VanGame666/Thermal_imager/Picture/正面.png

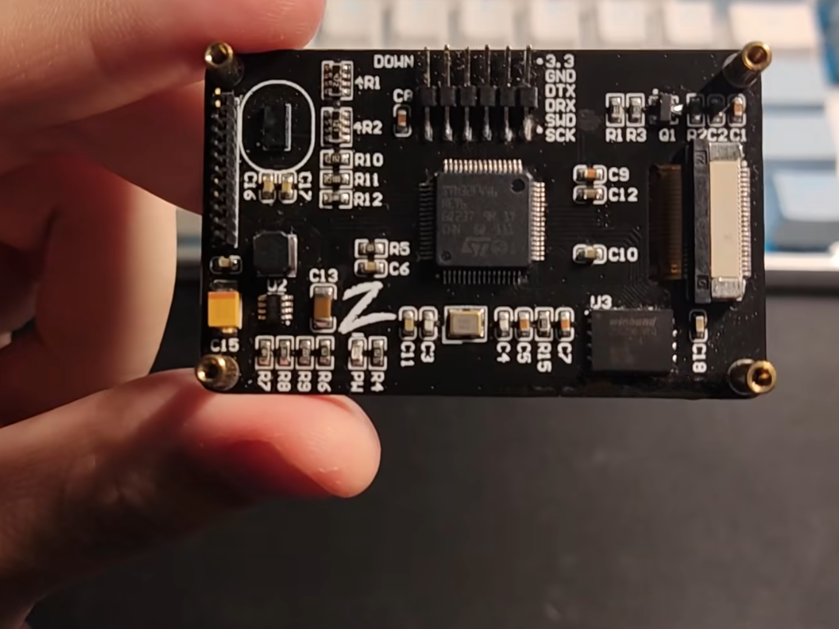
Picture/正面.png
