VanGame666/Thermal_imager/Picture/效果2.png

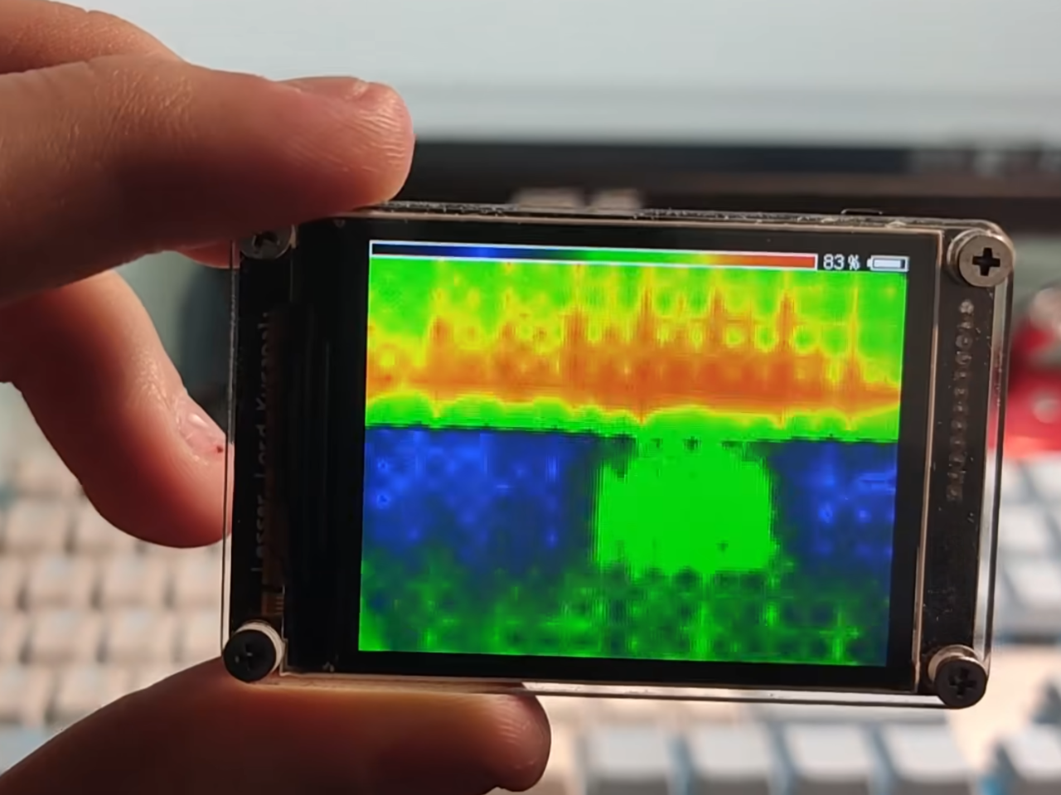
Picture/效果2.png
