VanGame666/Thermal_imager/Picture/Thermal_imager_Pcb(Down).png

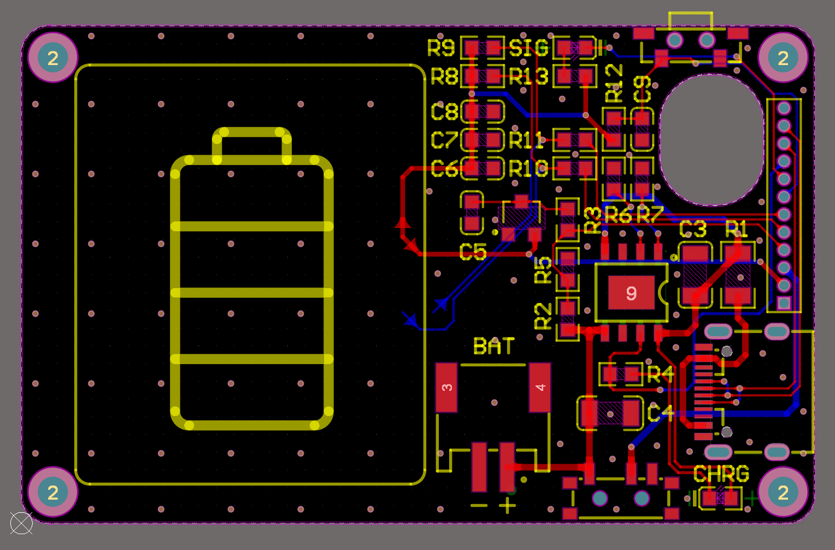
Picture/Thermal_imager_Pcb(Down).png
