VanGame666/Thermal_imager/Picture/Thermal_imager_Pcb(Up).png

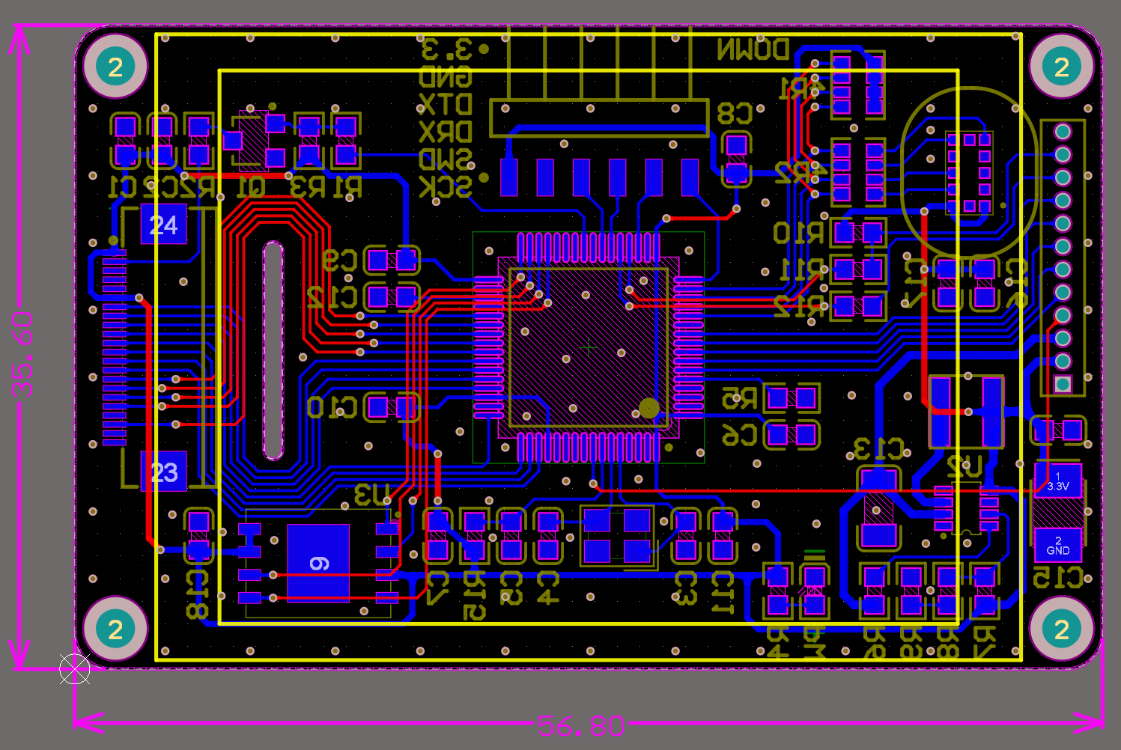
Picture/Thermal_imager_Pcb(Up).png
