VanGame666/Thermal_imager/Picture/Thermal_imager_Sch(Down).png

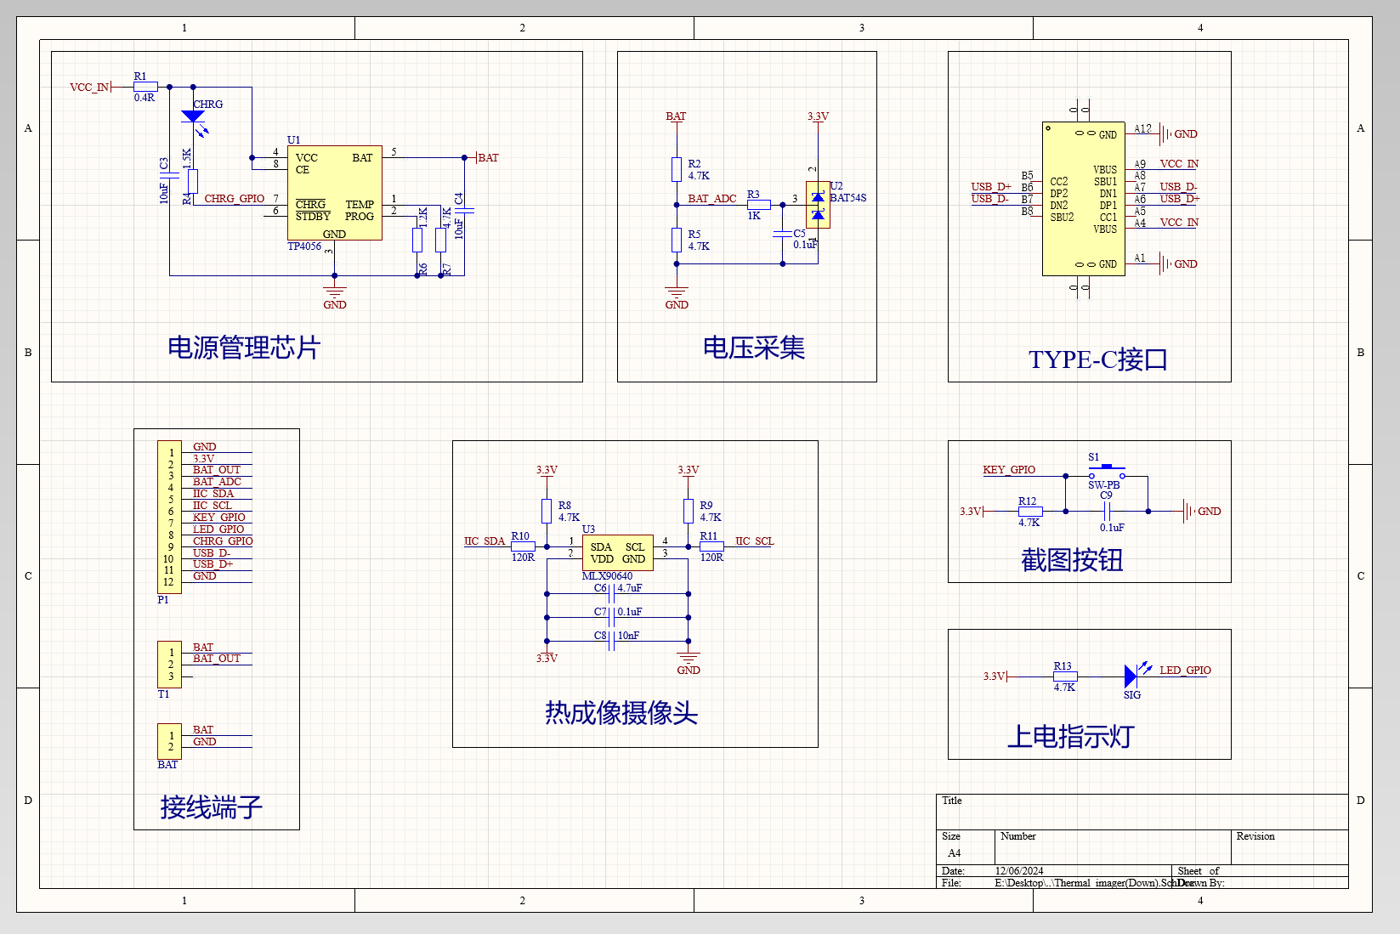
Picture/Thermal_imager_Sch(Down).png
