VanGame666/Thermal_imager/Picture/Thermal_imager_Sch(Up).png

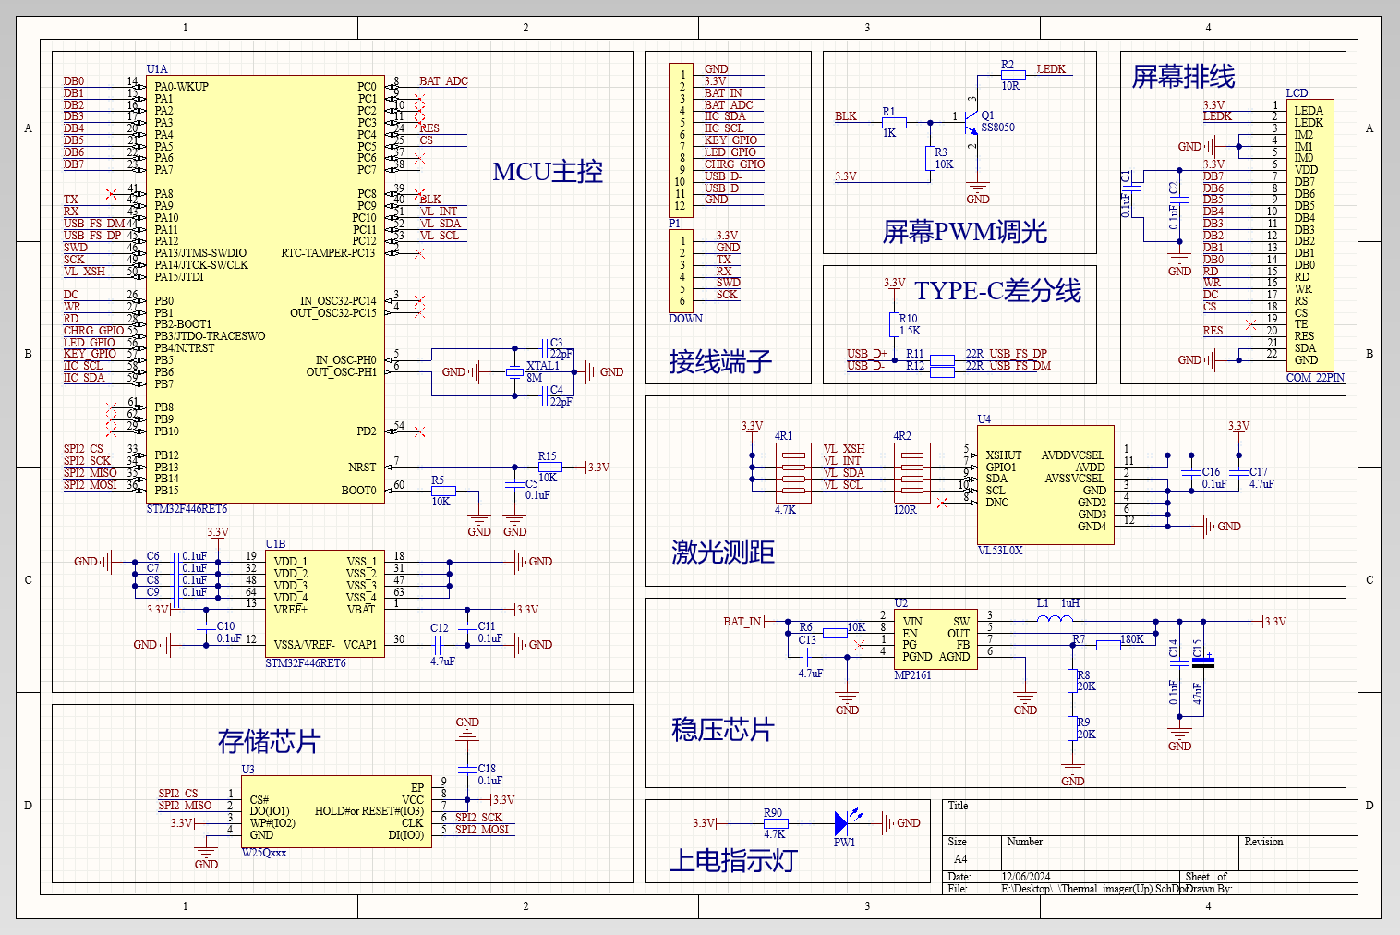
Picture/Thermal_imager_Sch(Up).png
