VanGame666/Thermal_imager/Picture/反面.png

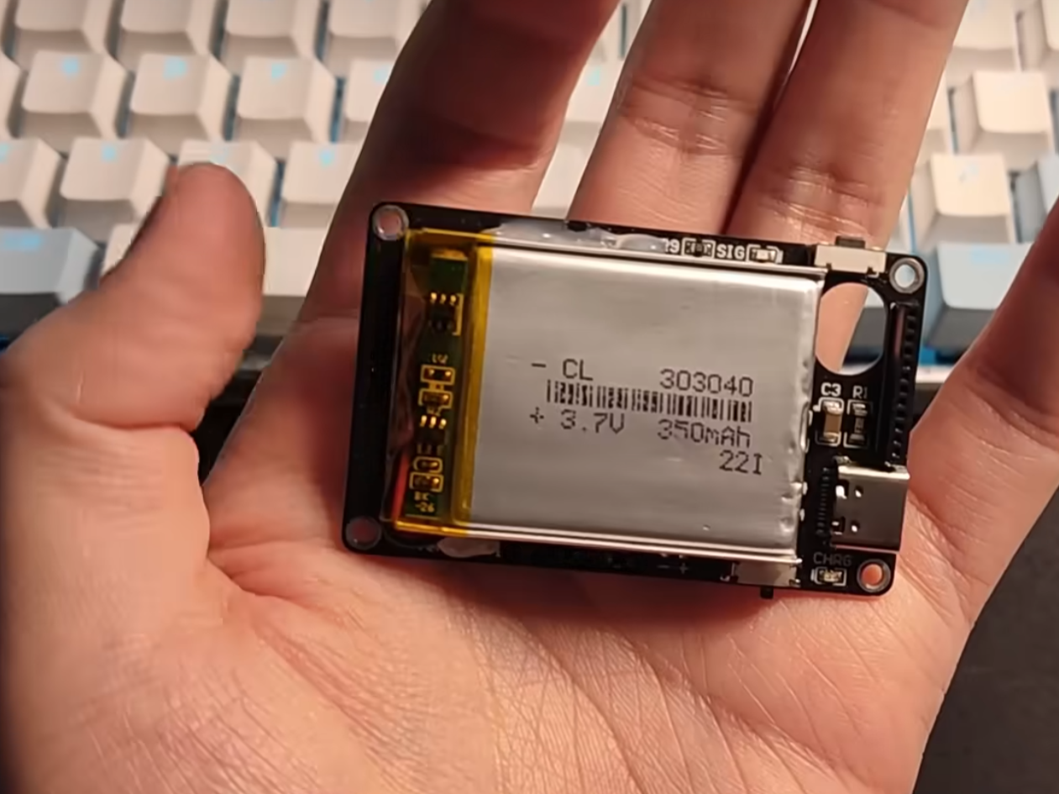
Picture/反面.png
