VanGame666/Thermal_imager/Picture/屏幕.png

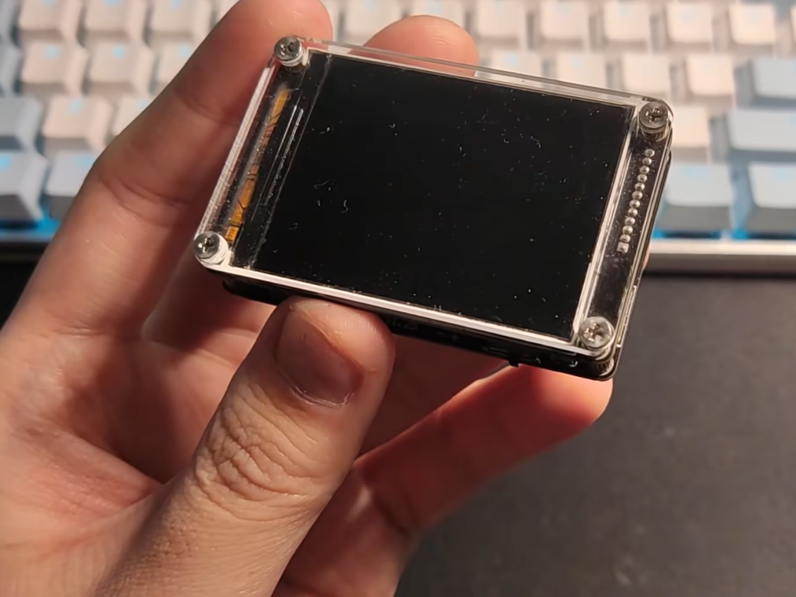
Picture/屏幕.png
