VanGame666/Thermal_imager/Picture/效果1.png

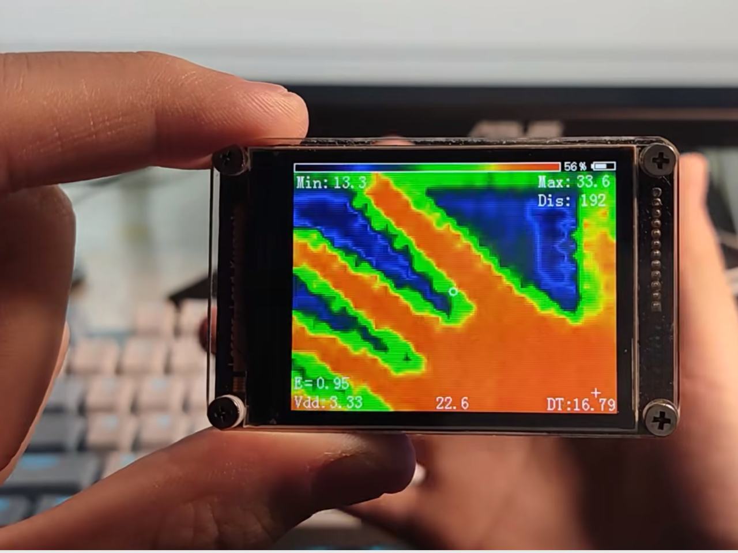
Picture/效果1.png
