VanGame666/Thermal_imager/(list of files, drawings)

Other design files:
Hardware/Thermal_imager(Down)/Thermal_imager(Down).PcbDoc
Hardware/Thermal_imager(Down)/Thermal_imager(Down).PrjPcb
Hardware/Thermal_imager(Down)/Thermal_imager(Down).SchDoc
Hardware/Thermal_imager(Up)/Thermal_imager(Up).PcbDoc
Hardware/Thermal_imager(Up)/Thermal_imager(Up).PrjPcb
Hardware/Thermal_imager(Up)/Thermal_imager(Up).SchDoc
