VanGame666/Thermal_imager/Software/Core/Src/main.c

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
/* Includes ------------------------------------------------------------------*/
#include "main.h"
#include "adc.h"
#include "dma.h"
#include "fatfs.h"
#include "i2c.h"
#include "spi.h"
#include "tim.h"
#include "usart.h"
#include "usb_device.h"
#include "gpio.h"

/* USER CODE BEGIN Includes */

#include <stdio.h>
#include <Processing_library.h>

#include "lcd.h"
#include "lcd_init.h"
#include "w25qxx.h"
#include "vl53l0x.h"
#include "mlx90640.h"
#include "bmp.h"
#include "usbd_core.h"
#include "pic.h"

/* USER CODE END Includes */


/* USER CODE BEGIN PV */

FATFS fs;													/* FatFs文件系统对象 */
FIL file;													/* 文件对象 */
FRESULT f_res;                    /* 文件操作结果 */
UINT fnum;            					  /* 文件成功读写数量 */
BYTE ReadBuffer[1024]={0};        /* 读缓冲区 */
BYTE WriteBuffer[]= "MY shi zhen shuai a\n\r";/* 写缓冲区*/  
BYTE fatfs_work[1024];

/* USER CODE END PV */

void SystemClock_Config(void);
/* USER CODE BEGIN 0 */

uint8_t key_down_sign = 0;		//按键按下标志位

DEVIE_STATE devie_state;

/* USER CODE END 0 */

/**
  * @brief  The application entry point.
  * @retval int
  */
int main(void)
{
  /* MCU Configuration--------------------------------------------------------*/

  /* Reset of all peripherals, Initializes the Flash interface and the Systick. */
  HAL_Init();

  /* Configure the system clock */
  SystemClock_Config();

  /* Initialize all configured peripherals */
  MX_GPIO_Init();
  MX_DMA_Init();
  MX_ADC1_Init();
  MX_I2C1_Init();
  MX_SPI2_Init();
  MX_TIM3_Init();
  MX_USART1_UART_Init();
//  MX_FATFS_Init();
//  MX_USB_DEVICE_Init();
  MX_TIM5_Init();
  MX_TIM6_Init();
  MX_TIM7_Init();
  /* USER CODE BEGIN 2 */

	//LCD
	TIM3 -> CCR4 = 0;
	HAL_TIM_PWM_Start(&htim3,TIM_CHANNEL_4);
	LCD_Init();
	LCD_Fill(0,0,LCD_W,LCD_H,BLACK);
	TIM3 -> CCR4 = LCD_START_LIGHT;

	//W25Qxx
	W25QXX_Init();
	while(W25QXX_ReadID()!=W25Q256)
	{
			printf("w25qxx error\r\n");
			HAL_Delay(1000);
	}
	//MX_USB_DEVICE_Init();
	MX_FATFS_Init();

	//VL53L0x	 
	while(vl53l0x_init(&vl53l0x_dev))//vl53l0x初始化
	{	 
			printf("VL53L0X Error!!!\r\n"); 
			HAL_Delay(1000);
	}
	
	//MLX90640
	Mlx90640_Init();
	
	//LCD静态显示
	Disp_Temp_Ribbon();
	Disp_Bat_Frame();


	HAL_TIM_Base_Start_IT(&htim5);
	HAL_TIM_Base_Start_IT(&htim6);
	HAL_TIM_Base_Start_IT(&htim7);

  /* USER CODE END 2 */

  /* Infinite loop */
  /* USER CODE BEGIN WHILE */
	
	f_res = f_mount(&fs,(TCHAR const*)USERPath,1);		//挂载Fatfs系统
	devie_state = DEVIE_RUN;
	
	printf("All Devie ok\r\n");
	
  while (1)
	{
		//vl53l0测距
		if(tim6_time1 >= 500)
		{
				tim6_time1 = 0;

				Get_Vl53l0x_Data();
		}
		
		//电池显示相关
		if(tim6_time2 >= 1000)
		{
				tim6_time2 = 0;
			
				bat_adc_scale = Bat_Adc_Change_Scale(bat_adc_val,BAT_MAX,BAT_MIN);
			
				if(Historical_Differences(bat_adc_scale,0) == MY_UNPASS)		Disp_Bat_Scale(bat_adc_scale);
		}
		
		//mlx90640转换完成
		if(Mlx90640_Get_Frame() == 1)
		{
				if(devie_state == DEVIE_RUN)
				{
						Disp_Temp_Pic();		//屏幕显示图像
						Disp_Dlc_Mod();			//显示额外的信息
				}
		}

	
		
		//按键
		if(HAL_GPIO_ReadPin(KEY_GPIO_Port,KEY_Pin) == GPIO_PIN_RESET)
		{
				key_scan_count = 0;
			
				HAL_Delay(50);
				while((HAL_GPIO_ReadPin(KEY_GPIO_Port,KEY_Pin) == GPIO_PIN_RESET) && (key_down_sign == 0))
				{
						if(key_scan_count >= 20)		//按键长按
						{
								key_down_sign = 1;
							
								if(devie_state == DEVIE_RUN)		//进入调试模式
								{
										devie_state = DEVIE_DEBUG;
									
										//显示信息
										printf("挂载USB设备\r\n");
										LCD_Fill(0,0,LCD_W,LCD_H,BLACK);
										LCD_ShowString(100,10,"Debug Mode",WHITE,BLACK,24,1);
										Disp_Bat_Frame();
										Disp_Bat_Scale(bat_adc_scale);
									
										LCD_ShowString(20,50,"Connect the computer in this state,",WHITE,BLACK,16,1);
										LCD_ShowString(25,75,"Copy the recorded pictures to the",WHITE,BLACK,16,1);
										LCD_ShowString(124,100,"computer.",WHITE,BLACK,16,1);
									
										LCD_ShowString(51,120,"Type-C",WHITE,BLACK,16,1);
										LCD_ShowPicture(50,140,50,50,gImage_usb_pic);
										for(int i=0;i<5;i++)		LCD_DrawLine(113+i*20,165,123+i*20,165,WHITE);
										LCD_ShowString(221,120,"Type-A",WHITE,BLACK,16,1);
										LCD_ShowPicture(220,140,50,50,gImage_computer_pic);
										
										//LCD_ShowPicture(275,183,35,35,gImage_logo_pic);
										LCD_ShowChinese(219,201,"我敢点煤气罐",WHITE,BLACK,16,1);
										LCD_ShowString(188,220,"Tell:1529214----",WHITE,BLACK,16,1);
									
										//切换挂载的设备
										f_res = f_mount(NULL,(TCHAR const*)USERPath,1);		//取消挂载
										FATFS_UnLinkDriver(USERPath);											//注销FatFs设备
									
										MX_USB_DEVICE_Init();
								}
								else
								{
										devie_state = DEVIE_RUN;
									
										//显示信息
										printf("挂载FATFS设备\r\n");
										Disp_Temp_Ribbon();
								
										//切换挂载设备
										USBD_LL_Stop(&hUsbDeviceFS);
									 
										MX_FATFS_Init();
										f_res = f_mount(&fs,(TCHAR const*)USERPath,1);		//挂载Fatfs系统
								}
						}
				}
				if(key_down_sign == 0)		//按键单击
				{
						if(devie_state == DEVIE_RUN)		//运行模式
						{
								if(Screen_Cut_Pic() == 0)		printf("图片写入成功\r\n");
								else												printf("图片写入失败\r\n");
						}
					

				}
		}
		else if(key_down_sign == 1 && (HAL_GPIO_ReadPin(KEY_GPIO_Port,KEY_Pin) == GPIO_PIN_SET))		//按键释放
		{
				key_down_sign = 0;
		}
		
		


		
    /* USER CODE END WHILE */

    /* USER CODE BEGIN 3 */
  }
  /* USER CODE END 3 */
}

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
