VanGame666/Thermal_imager/Software/Drivers/MLX90640/functions/mlx90640.c

#include "mlx90640.h"
#include "MLX90640_API.h"
#include "MLX90640_I2C_Driver.h"

#include <Processing_library.h>

#include <stdio.h>
#include <math.h>

#include "lcd.h"
#include "vl53l0x.h"



paramsMLX90640 mlx90640;

static uint16_t eeMLX90640[834];		//原始数组
static uint16_t mlx90640To[768];		//计算后的原始数据数组
static uint16_t mlx90640_disp_buf[768];		//镜像显示数组

static uint16_t mlx90640_temp_buf[25];		//双线性内插法后的原始数组
static uint16_t mlx90640_lcd_buf[100];		//放大后单个网格显示的数组
static uint16_t mlx90640_line_buf[3100];	//单行的数据数组

int mlx90640_max_temp = 0;		//数组中最高温度
int mlx90640_min_temp = 0;		//数组中最低温度
int mlx90640_med_temp = 0;		//设备最中心温度

float mlx90640_vdd = 0;			//mlx90640设备电压
float mlx90640_temp = 0;		//mlx90640设备温度

float emissivity = 0.95;

uint16_t mlx90640_status;



const uint16_t pseudo2[] = {  
0x0000,0x0000,0x0000,0x0001,0x0001,0x0002,0x0002,0x0003,
0x0003,0x0004,0x0004,0x0005,0x0005,0x0006,0x0006,0x0007,
0x0007,0x0008,0x0008,0x0009,0x0009,0x000A,0x000A,0x000B,
0x000B,0x000C,0x000C,0x000D,0x000D,0x000E,0x000E,0x000F,
0x000F,0x000F,0x0010,0x0010,0x0011,0x0011,0x0012,0x0012,
0x0013,0x0013,0x0014,0x0014,0x0015,0x0015,0x0016,0x0016,
0x0017,0x0017,0x0018,0x0018,0x0019,0x0019,0x001A,0x001A,
0x001B,0x001B,0x001C,0x001C,0x001D,0x001D,0x001E,0x001E,
0x001E,0x001E,0x003D,0x005D,0x007C,0x009C,0x00BB,0x00DB,
0x00FA,0x011A,0x0139,0x0159,0x0178,0x0198,0x01B7,0x01D7,
0x01F6,0x0216,0x0235,0x0255,0x0274,0x0294,0x02B3,0x02D3,
0x02F2,0x0312,0x0331,0x0351,0x0370,0x0390,0x03AF,0x03CF,
0x03EF,0x040E,0x042E,0x044D,0x046D,0x048C,0x04AC,0x04CB,
0x04EB,0x050A,0x052A,0x0549,0x0569,0x0588,0x05A8,0x05C7,
0x05E7,0x0606,0x0626,0x0645,0x0665,0x0684,0x06A4,0x06C3,
0x06E3,0x0702,0x0722,0x0741,0x0761,0x0780,0x07A0,0x07C0,
0x07E0,0x07E0,0x07E0,0x0FE0,0x0FE0,0x17E0,0x17E0,0x1FE0,
0x1FE0,0x27E0,0x27E0,0x2FE0,0x2FE0,0x37E0,0x37E0,0x3FE0,
0x3FE0,0x47E0,0x47E0,0x4FE0,0x4FE0,0x57E0,0x57E0,0x5FE0,
0x5FE0,0x67E0,0x67E0,0x6FE0,0x6FE0,0x77E0,0x77E0,0x7FE0,
0x7FE0,0x7FE0,0x87E0,0x87E0,0x8FE0,0x8FE0,0x97E0,0x97E0,
0x9FE0,0x9FE0,0xA7E0,0xA7E0,0xAFE0,0xAFE0,0xB7E0,0xB7E0,
0xBFE0,0xBFE0,0xC7E0,0xC7E0,0xCFE0,0xCFE0,0xD7E0,0xD7E0,
0xDFE0,0xDFE0,0xE7E0,0xE7E0,0xEFE0,0xEFE0,0xF7E0,0xF7E0,
0xFFC0,0xFFA0,0xFF80,0xFF60,0xFF40,0xFF20,0xFF00,0xFEE0,
0xFEC0,0xFEA0,0xFE80,0xFE60,0xFE40,0xFE20,0xFE00,0xFDE0,
0xFDC0,0xFDA0,0xFD80,0xFD60,0xFD40,0xFD20,0xFD00,0xFCE0,
0xFCC0,0xFCA0,0xFC80,0xFC60,0xFC40,0xFC20,0xFC00,0xFBE0,
0xFBC0,0xFBA0,0xFB80,0xFB60,0xFB40,0xFB20,0xFB00,0xFAE0,
0xFAC0,0xFAA0,0xFA80,0xFA60,0xFA40,0xFA20,0xFA00,0xF9E0,
0xF9C0,0xF9A0,0xF980,0xF960,0xF940,0xF920,0xF900,0xF8E0,
0xF8C0,0xF8A0,0xF880,0xF860,0xF840,0xF820,0xF800,0xF800
};

/*******************************************************************************
	* @name:				Mlx90640_Init	
	* @instructions:		MLX90640初始化
	* @input:				NULL
	* @output:				NULL
	*****************************************************************************/
void Mlx90640_Init(void)
{
		MLX90640_I2CInit();		//初始化IO口
	
		MLX90640_SetRefreshRate(MLX90640_ADDR, RefreshRate);		//设置帧率
		MLX90640_SetChessMode(MLX90640_ADDR);		//棋盘模式
	
		mlx90640_status = MLX90640_DumpEE(MLX90640_ADDR, eeMLX90640);		//读取像素校正参数 
		if (mlx90640_status != 0) printf("load system parameters error with code:%d\r\n",mlx90640_status);
	
		mlx90640_status = MLX90640_ExtractParameters(eeMLX90640, &mlx90640);		//解析校正参数
		if (mlx90640_status != 0) printf("Parameter extraction failed with error code:%d\r\n",mlx90640_status);

		for(int i=0;i<3;)
		{
				MLX90640_I2CRead(MLX90640_ADDR, 0x8000, 1, &mlx90640_status);

				if(mlx90640_status & 0x0008)
				{
						int status = MLX90640_GetFrameData(MLX90640_ADDR, eeMLX90640);  //读取一帧原始数据
						if (status < 0)		printf("GetFrame Error: %d\r\n",status);
						
						mlx90640_vdd = MLX90640_GetVdd(eeMLX90640, &mlx90640);  //计算 Vdd（这句可有可无）
						mlx90640_temp = MLX90640_GetTa(eeMLX90640, &mlx90640);  //计算实时外壳温度
						mlx90640_temp = mlx90640_temp - TA_SHIFT;
						MLX90640_CalculateTo(eeMLX90640,&mlx90640,emissivity,mlx90640_temp,mlx90640To);		//计算像素点温度

						//printf("vdd: %f Tr: %f\r\n",mlx90640_vdd,mlx90640_temp);
						
						i++;
				}
		}
}


/*******************************************************************************
	* @name:				Mlx90640_Get_Frame	
	* @instructions:		MLX90640获取一帧数据
	*
	* @input:				NULL
	* @output:				out		状态标志位
	*****************************************************************************/
uint8_t Mlx90640_Get_Frame(void)
{
		uint8_t flag = 0;
		mlx90640_status = 0;
	
		MLX90640_I2CRead(MLX90640_ADDR, 0x8000, 1, &mlx90640_status);

		if(mlx90640_status & 0x0008)
		{
				int status = MLX90640_GetFrameData(MLX90640_ADDR, eeMLX90640);  //读取一帧原始数据
				if (status < 0)		printf("GetFrame Error: %d\r\n",status);
				
				mlx90640_vdd = MLX90640_GetVdd(eeMLX90640, &mlx90640);  //计算 Vdd（这句可有可无）
				mlx90640_temp = MLX90640_GetTa(eeMLX90640, &mlx90640);  //计算实时外壳温度
				mlx90640_temp = mlx90640_temp - TA_SHIFT;
				MLX90640_CalculateTo(eeMLX90640,&mlx90640,emissivity,mlx90640_temp,mlx90640To);		//计算像素点温度

				//printf("vdd: %f Tr: %f\r\n",mlx90640_vdd,mlx90640_temp);
				
				flag = 1;
		}
		
		return flag;
}




/*******************************************************************************
	* @name:				Disp_Temp_Pic	
	* @instructions:		MLX90640显示一帧数据
	* @input:				NULL
	* @output:				NULL
	*****************************************************************************/
void Disp_Temp_Pic(void)
{
		uint16_t count = 0;

		//数据镜像
		for(int i=0;i<24;i++)
		{
				for(int j=0;j<32;j++)
				{
						mlx90640_disp_buf[i*32+j] = mlx90640To[i*32+31-j] + TEMP_ADD;
				}
		}

		//获取设备最高最低温度
		mlx90640_max_temp = Array_Return_Max(mlx90640_disp_buf,768);
		mlx90640_min_temp = Array_Return_Min(mlx90640_disp_buf,768);
		mlx90640_med_temp = (mlx90640_disp_buf[399]+mlx90640_disp_buf[400]+mlx90640_disp_buf[431]+mlx90640_disp_buf[432])/4;
		

		//数据显示（滤波优化显示）
		for(int i=0;i<23;i++)
		{
				for(int j=0;j<31;j++)
				{
						//双线性插值算法
						Bilinear_Interpolation(i*32+j);
						
						//将数据转换为显示颜色
						for(int k=0;k<25;k++)		mlx90640_temp_buf[k] = pseudo2[Temp_Change_Bit(mlx90640_temp_buf[k]-400,mlx90640_max_temp-390,mlx90640_min_temp-430)];
					
						//数据数组放大
						count = 0;
						for(int k=0;k<5;k++)
						{
								for(int l=0;l<5;l++)
								{
										mlx90640_lcd_buf[l*2+k*20] = mlx90640_temp_buf[count];
										mlx90640_lcd_buf[l*2+k*20+1] = mlx90640_temp_buf[count];
									
										mlx90640_lcd_buf[l*2+k*20+10] = mlx90640_temp_buf[count];
										mlx90640_lcd_buf[l*2+k*20+11] = mlx90640_temp_buf[count];
										count++;
								}
						}
							
						//将单格数据排列入整行数据数组
						count = 0;
						for(int k=0;k<10;k++)
						{
								for(int l=0;l<10;l++)
								{
										mlx90640_line_buf[k*310+j*10+l] = mlx90640_lcd_buf[count];
										count++;
								}
								
						}
				}
				
				LCD_Fill_Buf(5,i*10+9,315,i*10+19,mlx90640_line_buf);
		}
}

/*******************************************************************************
	* @name:				Disp_Dlc_Mod	
	* @instructions:		显示额外的信息
	* @input:				NULL
	* @output:				NULL
	*****************************************************************************/
void Disp_Dlc_Mod(void)
{
		//跟踪显示图片中最高温度
		uint16_t address,x,y,sta;

		address = Array_Return_Max_Sub_Z(mlx90640_disp_buf,768);
		x = address%32*10+5;
		y = address/32*10+9;
	
		if(x == 315)		x--;
		if(y == 239)		y--;
	
		sta = x-4;
		for(int i=0;i<9;i++)
		{
				if((sta+i)>5 && (sta+i)<315)
				{
						LCD_DrawPoint(sta+i,y,WHITE);
				}
		}
	
		sta = y-4;
		for(int i=0;i<9;i++)
		{
				if((sta+i)>9 && (sta+i)<239)
				{
						LCD_DrawPoint(x,sta+i,WHITE);
				}
		}
		
		//显示最高最低温度		
		LCD_ShowString(8,10,"Min:",WHITE,BLACK,16,1);
		LCD_Show_Temp_Superposition(60,10,mlx90640_min_temp-400,WHITE,BLACK);
		
		LCD_ShowString(242,10,"Max:",WHITE,BLACK,16,1);
		LCD_Show_Temp_Superposition(294,10,mlx90640_max_temp-400,WHITE,BLACK);
		
		//显示距离
		LCD_ShowString(242,28,"Dis:",WHITE,BLACK,16,1);
		LCD_Show_Dis_Superposition(294,28,Vl53l0x_Data_Z.distance,WHITE,BLACK);

		//显示热系数
		LCD_ShowString(8,204,"E",WHITE,BLACK,16,1);
		LCD_ShowString(18,204,"=",WHITE,BLACK,16,1);
		LCD_Show_Vdd_Superposition(45,204,emissivity,WHITE,BLACK);
		
		//显示设备电压
		LCD_ShowString(8,222,"Vdd:",WHITE,BLACK,16,1);
		LCD_Show_Vdd_Superposition(58,222,mlx90640_vdd,WHITE,BLACK);
		
		//显示中心圆和温度
		Draw_Circle(160,124,4,WHITE);
		LCD_Show_Temp_Superposition(160,222,mlx90640_med_temp-400,WHITE,BLACK);
		
		//显示设备本身温度
		LCD_ShowString(250,222,"DT:",WHITE,BLACK,16,1);
		LCD_Show_Vdd_Superposition(294,222,mlx90640_temp,WHITE,BLACK);
}

/*******************************************************************************
	* @name:				Disp_Temp_Ribbon	
	* @instructions:		显示温度色带
	* @input:				NULL
	* @output:				NULL
	*****************************************************************************/
void Disp_Temp_Ribbon(void)
{
		LCD_DrawRectangle(5,0,262,8,WHITE);
		for(int i=0;i<256;i++)		LCD_DrawLine(i+6,1,i+6,8,pseudo2[i]);
}
	
	
/*******************************************************************************
	* @name:				Bilinear_Interpolation	
	* @instructions:		双线性插值算法
	* @input:				flag	位置信息
	* @output:				NULL
	*****************************************************************************/
void Bilinear_Interpolation(uint16_t flag)
{
		uint16_t scale_x = 102;		//512/5=102
		uint16_t scale_y = 102;		//512/5=102
	
		uint16_t cbufx[2],cbufy[2];
		int x,y;
	
    for (y = 0; y < 5; y++)
    {
        cbufy[0] = 512-y*scale_y;
        cbufy[1] = 512-cbufy[0];
		
        for (x = 0; x < 5; x++)
        {
						cbufx[0] = 512-x*scale_x;
						cbufx[1] = 512-cbufx[0];

						mlx90640_temp_buf[y*5+x] = (mlx90640_disp_buf[flag   ] * cbufx[0] * cbufy[0] + 
													mlx90640_disp_buf[flag+32] * cbufx[0] * cbufy[1] + 
													mlx90640_disp_buf[flag+1 ] * cbufx[1] * cbufy[0] + 
													mlx90640_disp_buf[flag+33] * cbufx[1] * cbufy[1] )>>18;
        }
		}
}



/*******************************************************************************
	* @name:				Temp_Change_Bit	
	* @instructions:		温度转换为单字节数值
	* @input:				temp	输入的温度
	* @output:				mul		
	*****************************************************************************/
uint8_t Temp_Change_Bit(int temp,int max,int min)
{
		static float mul;
	
		if(temp > max)		temp = max;
		if(temp < min)		temp = min;

		mul = ((float)(temp - min)/(float)(max - min));
	
		return mul *255;
}

/*******************************************************************************
	* @name:				Bit_Change_Colour	
	* @instructions:		字节转换为颜色
	* @input:				value		字节数值
	*						flag		转换方案
	* @output:				out			颜色16位
	*****************************************************************************/
uint16_t Bit_Change_Colour(uint8_t value,uint8_t flag)
{
		uint16_t out_data;
		uint8_t colorR,colorG,colorB;
	
		switch(flag)
		{
				case 1:		//黑白灰
				{
						colorR = (float)value/256*31;
						colorG = (float)value/256*63;
						colorB = (float)value/256*31;
					
						break;
				}
				case 2:		//伪彩色2
				{
						if(value<=63)  
						{
							colorR = 0;
							colorG = 0;
							colorB = (float)value/64*31;
						}
						else if((value>=64) && (value<=127))  
						{
							colorR = 0;
							colorG = (float)(value-64)/64*63;
							colorB = (float)(127-value)/64*31;
						}
						else if((value>=128) && (value<=191))  
						{
							colorR = (float)(value-128)/64*31;
							colorG = 63;
							colorB = 0;
						}
						else if((value>=192) && (value<=255))  
						{
							colorR = 31;
							colorG = (float)(255-value)/64*63;
							colorB = 0;
						}		

						break;
				}
				case 3:		//彩虹2
				{
						if(value<=63)  
						{
								colorR=0;
								colorG=((float)value/64)*63;
								colorB=31;
						}
						else if((value>=64) && (value<=95))  
						{
								colorR=0;
								colorG=63;
								colorB=((float)(95-value)/32)*31;
						}
						else if((value>=96) && (value<=127))  
						{
								colorR=((float)(value-96)/32)*31;
								colorG=63;
								colorB=0;
						}
						else if((value>=128) && (value<=191))  
						{
								colorR=31;
								colorG=((float)(191-value)/64)*63;
								colorB=0;
						}
						else if((value>=192) && (value<=255))  
						{
								colorR=31;
								colorG=((float)(value-192)/64)*63;
								colorB=((float)(value-192)/64)*31;
						}
						break;

				}
				case 4:		//彩虹3
				{
						if(value<=51)  
						{
								colorR = 0;
								colorG = (float)(value*5)/256*63;
								colorB = 31;
						}
						else if((value>=52) && (value<=102))  
						{
								colorR = 0;
								colorG = 63;
								colorB = (float)(255-(value-51)*5)/256*31;
						}
						else if((value>=103) && (value<=153))  
						{
								colorR = (float)(5*value-510)/256*31;
								colorG = 63;
								colorB = 0;
						}
						else if((value>=154) && (value<=204))  
						{
								colorR = 31;
								colorG = (255-128*(float)(value-153)/51)/256*63;
								colorB = 0;
						}
						else if((value>=205) && (value<=255))  
						{
								colorR = 31;
								colorG = (127-127*(float)(value-204)/51)/256*63;
								colorB = 0;
						}
						break;
				}
				case 5:		//金属
				if(value<=63)  
				{
						colorR = 0;
						colorG = 0;
						colorB = ((float)value/64*255)/256*31;
				}
				else if((value>=64) && (value<=95))  
				{
						colorR = ((float)(value-63)/32*127)/256*31;
						colorG = ((float)(value-63)/32*127)/256*63;
						colorB = 31;
				}
				else if((value>=96) && (value<=127))  
				{
						colorR = (((float)(value-95)/32*127)+128)/256*31;
						colorG = (((float)(value-95)/32*127)+128)/256*63;
						colorB = ((float)(127-value)/32*255)/256*31;
				}
				else if((value>=128) && (value<=191))  
				{
						colorR = 31;
						colorG = 63;
						colorB = 0;
				}
				else if((value>=192) && (value<=255))  
				{
						colorR = 31;
						colorG = 63;
						colorB = (float)(value-192)/64*255/256*31;
				}
				break;

				default: break;
		}

		out_data = (colorR<<11)|(colorG<<5)|colorB;
	
		return out_data;
		
}
